Brvent/LSEI/README.md

# LSEI
Aquest projecte tracta de dissenyar i implementar un controlador de motor ESR
