Brvent/LSEI/Kicad/rcasado/ListaMaterial_CasadoRaul_VenturaBrandon.xlsx

Distribuidor | Dispositiu | Referència del fabricant | Referència del distribuïdor | Preu unitari | QUANTITAT Necessària | QUANTITAT Mínima | Preu Total | Link de compra | Comentaris
RS | Bloque de terminal PCB Macho RS PRO de 2 vías, paso 5.08mm, 10A, de color Verde, montaje Montaje en orificio pasante, | 146-8345 | 146-8345 | 0.584 € | 1 | 10 | 0.58 € | link (https://es.rs-online.com/web/p/bornes-para-pcb/1468345?gb=b) | Connector Alimentació (J6)
RS | Bloque de terminal PCB Hembra Ángulo recto RS PRO de 3 vías, paso 5.08mm, 25A, de color Verde, montaje Montaje en | 790-1155 | 790-1155 | 1.350 € | 1 | 5 | 1.35 € | link (https://es.rs-online.com/web/p/bornes-para-pcb/7901155?gb=b) | Connector Motor (J7)
RS | Regleta de pines Wurth Elektronik serie WR-PHD de 40 vías, 1 fila, paso 2.54mm, para soldar, Orificio Pasante | 61304011121 | 163-5305 | 0.72 € | 3 | 200 | 2.16 € | link (https://es.rs-online.com/web/p/conectores-macho-para-pcb/1635305?gb=s) | Tira mascle 2.54mm
RS | LED Lite-On, Rojo, 625 nm, Vf= 2,6 V, 60°, mont. pasante, encapsulado 3 mm (T-1) | LTL-4221N | 127-8400 | 0.07 € | 2 | 100 | 0.13 € | link (https://es.rs-online.com/web/p/leds/1278400?gb=s) | LED alimentació (D4, D5)
RS | MOSFET, IRFR1205TRPBF, N-Canal-Canal, 44 A, 55 V, 3-Pin, DPAK (TO-252) HEXFET Simple Si | IRFR1205TRPBF | 827-4026 | 1.31 € | 6 | 20 | 7.85 € | link (https://es.rs-online.com/web/p/mosfet/8303357/) | NMOS de potencia (Q1-Q7)
RS | Módulo controlador de puerta IR2301SPBF, CMOS, LSTTL 350 mA SOIC 8 pines | IR2301SPBF | 262-6704P | 1.32 € | 3 | 25 | 3.97 € | link (https://es.rs-online.com/web/p/drivers-de-potencia/2626704P) | Driver doble alt i baix per NMOS (IC2, IC3, IC4)
RS | Diodo, 1N4149, Pequeña señal, 500mA, 100V, 4ns, DO-35, 2-Pines | 1N4149 | 186-7651 | 0.04 € | 3 | 100 | 0.12 € | link (https://es.rs-online.com/web/p/diodos-schottky-y-rectificadores/1867651?gb=s) | Díode bootstrap (D1, D2, D3)
Farnell | Condensador Electrolítico Aluminio SMD, Radial - SMD, 470 µF, 35 V, 2000 horas a 105°C, Polar | MCVFZ035M471XB6L | 2627682 | 2.41 € | 1 | 1 | 2.41 € | link (https://es.farnell.com/multicomp/mcvfz035m471xb6l/conden-470-f-35v-smd/dp/2627682) | Condensador entrada alimentació radial SMT (C15)
RS | Potenciometro con película de carbono de 10kΩ, ±10%, 0.1W, serie RK163, 1 vuelta, eje de 6 mm de Ø, Montaje en Panel | RK1631110TWA | 172-6361 | 7.30 € | 1 | 1 | 7.30 € | link (https://es.rs-online.com/web/p/potenciometros/2499238?gb=s) | potenciometre de control duty ESC NO ES POT SOLDAR A LA PCB
RS | Regulador de tensión L7805CV, 1.5A, 3 pines | L7805CV | 918-1971 | 0.26 € | 1 | 50 | 0.26 € | link (https://es.rs-online.com/web/p/reguladores-de-tension/9181971?gb=s) | Regulador linial fix 5V, encapsulat TO-220 (U1)
RS | Regulador de tensión LMS8117AMP-3.3/NOPB, 1A SOT-223, 3+Tab pines | LMS8117AMP-3.3/NOPB | 536-0313P | 0.95 € | 1 | 15 | 0.95 € | link (https://es.rs-online.com/web/p/reguladores-de-tension/5360313P?cm_mmc=es-DS-APP-_-PCB-_-VIEW-_-5360313P) | Regulador 3.3V (IC5)
RS | Comparador LM339D Colector Abierto 1.3μs 4-Canales, 3 → 28 V 14-Pines SOIC | LM339D | 858-411 | 0.88 € | 1 | 1 | 0.88 € | link (https://es.rs-online.com/web/p/comparadores/0858411?gb=s) | Comparador BEMF (IC1)
Components SMD 1206
resistències | sèrie E6 des de 1Ohm fins a 1MEGOhm
condensadors (nF) | 0.1 - 1 - 2.2 - 3.3 - 4.7 - 6.8 - 10 - 22 -33 - 47 - 68 - 100 - 220 - 330 - 470 - 680 -1000 -2200 - 10000
