Brvent/LSEI/Kicad/rcasado/PCBLSE1_CasadoRaul_VenturaBrandon.kicad_pcb

## KiCad design Kicad/rcasado/PCBLSE1_CasadoRaul_VenturaBrandon.kicad_pcb (2026-10-15)

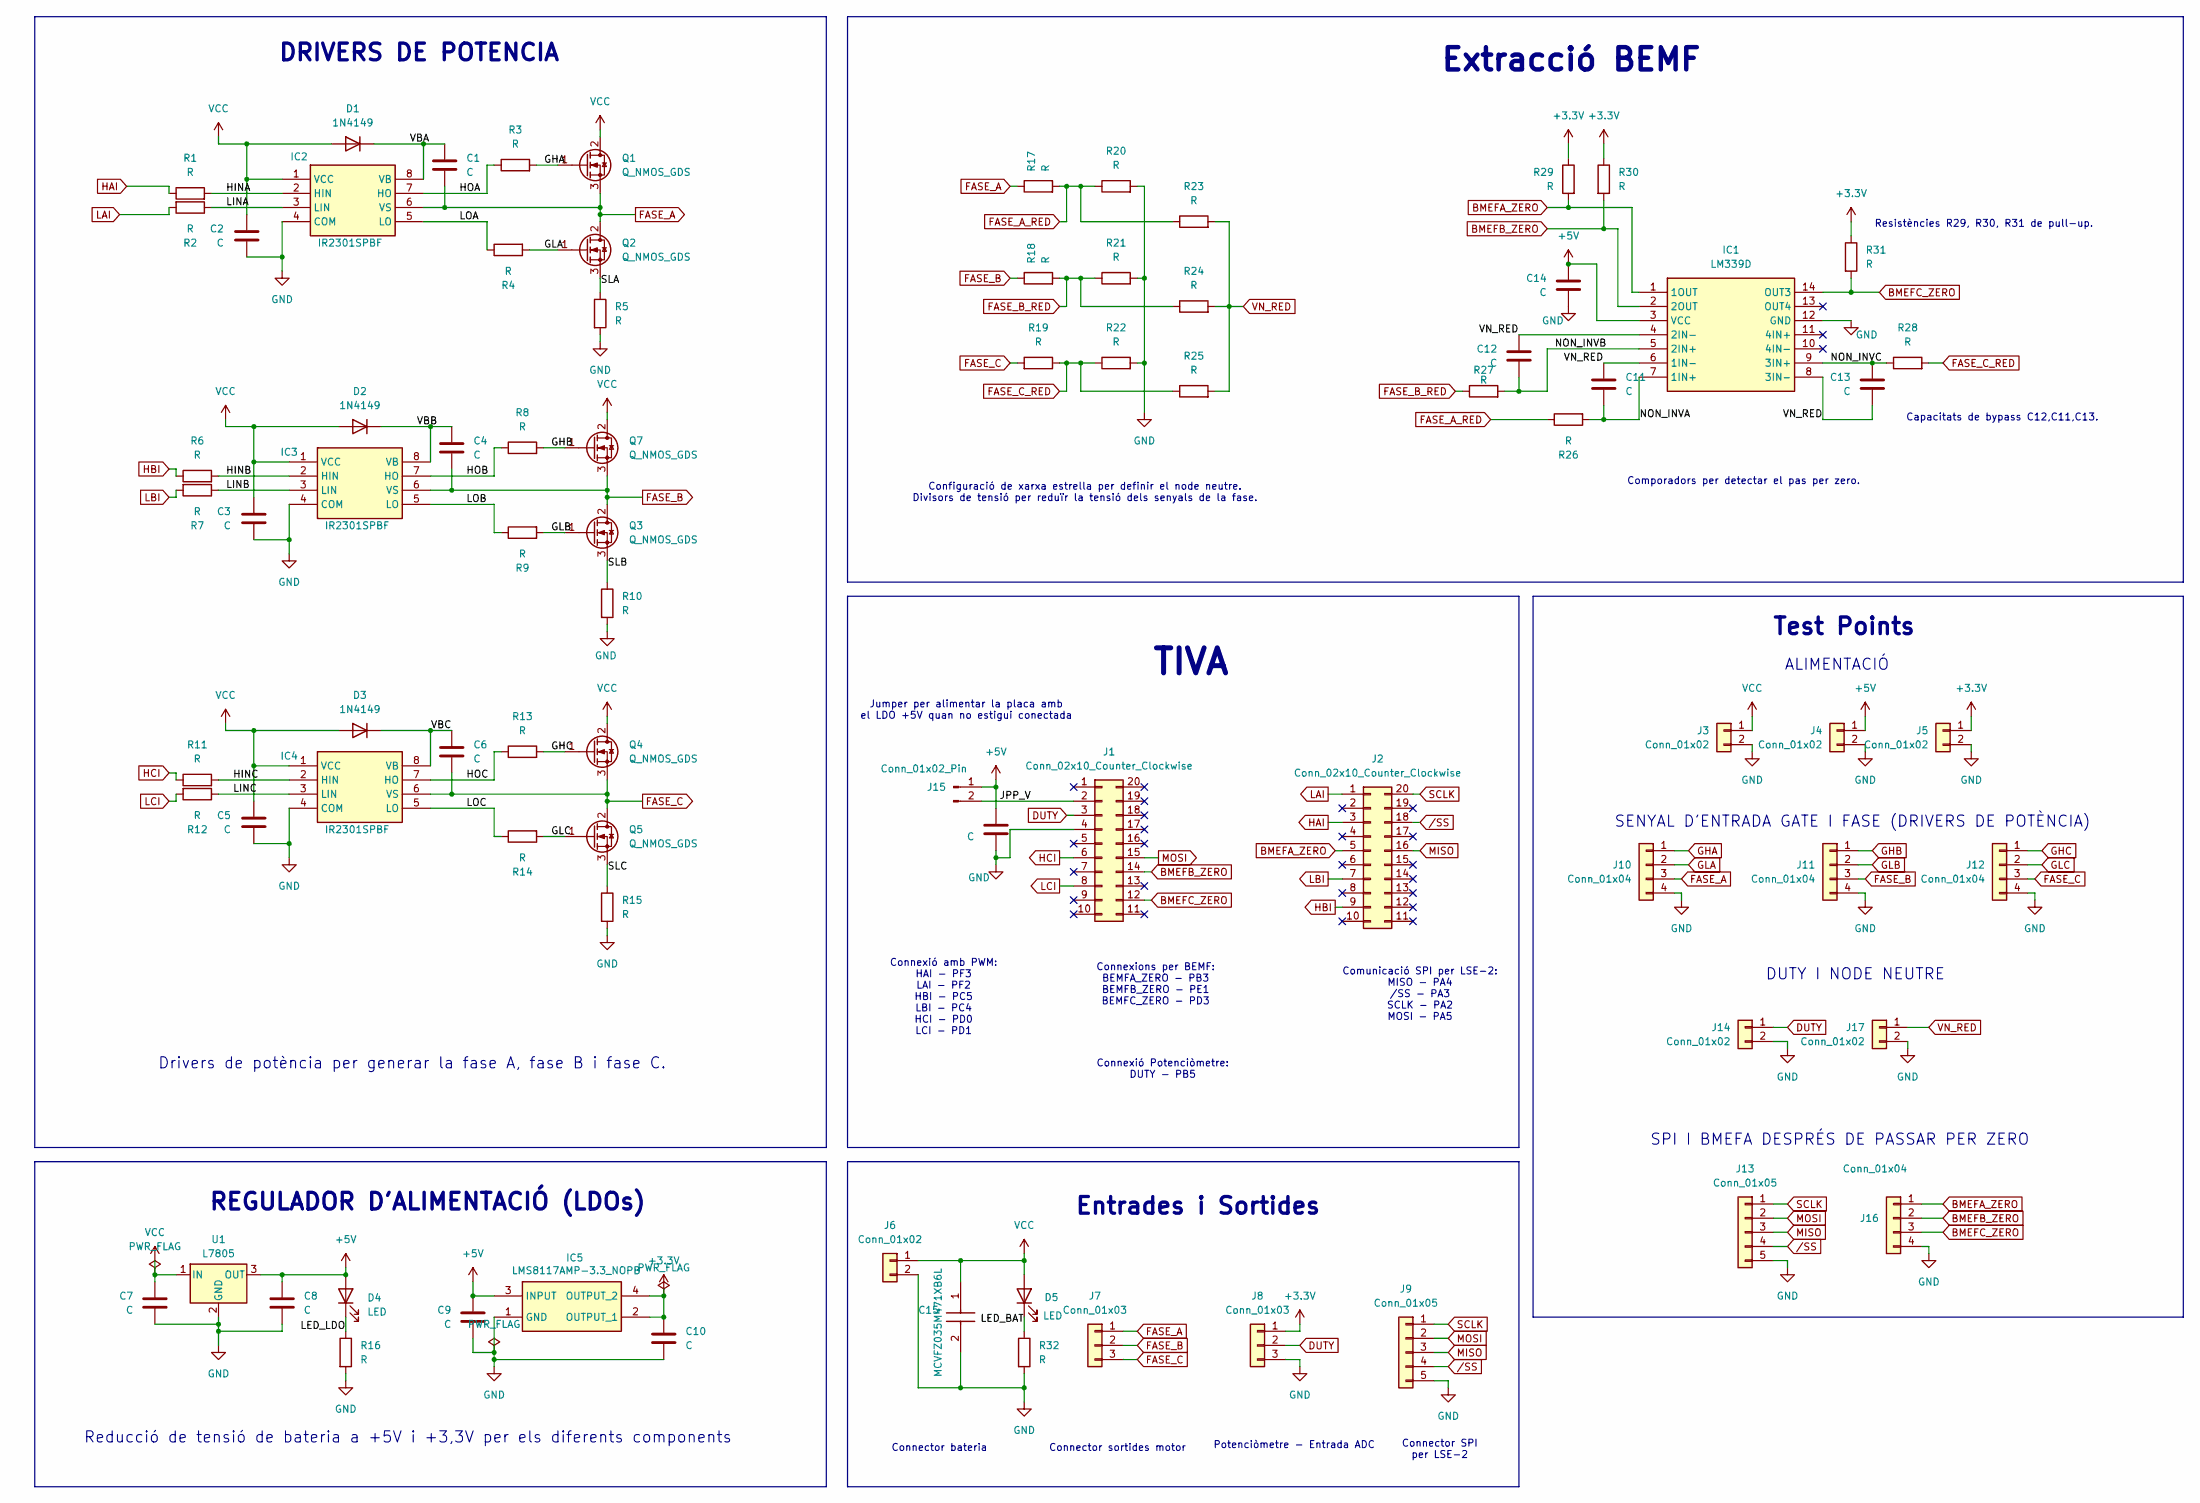
[picture p1: schematic PCBLSE1_CasadoRaul_VenturaBrandon.kicad_sch, PCB per control de velocitat de motor]

Parts:
C1, C2, C3, C4, C5, C6, C7, C8, C9, C10, C11, C12, C13, C14, C16: C; C_1206_3216Metric
C15: MCVFZ035M471XB6L; CAPAE1280X1300N; Manufacturer_Part_Number MCVFZ035M471XB6L
D1, D2, D3: 1N4149; D_DO-35_SOD27_P7.62mm_Horizontal
D4, D5: LED; LTL4221N
IC1: LM339D; SOIC127P600X175-14N; Mouser Part Number 595-LM339D
IC2, IC3, IC4: IR2301SPBF; SOIC127P600X175-8N; Mouser Part Number 942-IR2301SPBF
IC5: LMS8117AMP-3.3_NOPB; SOT230P700X180-4N; Mouser Part Number 926-LMS8117AMP33NOPB
J1, J2: Conn_02x10_Counter_Clockwise; PinHeader_2x10_P2.54mm_Vertical
J3, J4, J5, J14, J17: Conn_01x02; PinSocket_1x02_P2.54mm_Vertical
J6: Conn_01x02; TerminalBlock_Phoenix_MKDS-1,5-2-5.08_1x02_P5.08mm_Horizont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
J7: Conn_01x03; TerminalBlock_Phoenix_MKDS-1,5-3-5.08_1x03_P5.08mm_Horizont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
J8: Conn_01x03; PinSocket_1x03_P2.54mm_Vertical
J9, J13: Conn_01x05; PinSocket_1x05_P2.54mm_Vertical
J10, J11, J12, J16: Conn_01x04; PinSocket_1x04_P2.54mm_Vertical
J15: Conn_01x02_Pin; PinSocket_1x02_P2.54mm_Vertical
Q1, Q2, Q3, Q4, Q5, Q7: Q_NMOS_GDS; TO-252-2
R1, R2, R3, R4, R5, R6, R7, R8, R9, R10, R11, R12, R13, R14, R15, R16, R17, R18, R19, R20, R21, R22, R23, R24, R25, R26, R27, R28, R29, R30, R31, R32: R; R_1206_3216Metric
U1: L7805; TO255P460X1020X2008-3P

Connections:
+3.3V: C10.1, IC5.2 (OUTPUT_1), IC5.4 (OUTPUT_2), J5.1, J8.1, R29.1, R30.1, R31.1
+5V: C8.1, C9.1, C14.1, C16.1, D4.2 (A), IC1.3 (VCC), IC5.3 (INPUT), J4.1, J15.1, U1.3 (OUT)
/HINA: IC2.2 (HIN), R1.2
/HINB: IC3.2 (HIN), R6.2
/HINC: IC4.2 (HIN), R11.2
/HOA: IC2.7 (HO), R3.1
/HOB: IC3.7 (HO), R8.1
/HOC: IC4.7 (HO), R13.1
/JPP_V: J1.2, J15.2
/LED_BAT: D5.1 (K), R32.1
/LED_LDO: D4.1 (K), R16.1
/LINA: IC2.3 (LIN), R2.1
/LINB: IC3.3 (LIN), R7.1
/LINC: IC4.3 (LIN), R12.1
/LOA: IC2.5 (LO), R4.1
/LOB: IC3.5 (LO), R9.1
/LOC: IC4.5 (LO), R14.1
/NON_INVA: C11.2, IC1.7 (1IN+), R26.2
/NON_INVB: C12.2, IC1.5 (2IN+), R27.2
/NON_INVC: C13.1, IC1.9 (3IN+), R28.1
/SLA: Q2.3 (S), R5.1
/SLB: Q3.3 (S), R10.1
/SLC: Q5.3 (S), R15.1
/VBA: C1.1, D1.1 (K), IC2.8 (VB)
/VBB: C4.1, D2.1 (K), IC3.8 (VB)
/VBC: C6.1, D3.1 (K), IC4.8 (VB)
BMEFA_ZERO: IC1.1 (1OUT), J2.5, J16.1, R29.2
BMEFB_ZERO: IC1.2 (2OUT), J1.14, J16.2, R30.2
BMEFC_ZERO: IC1.14 (OUT3), J1.12, J16.3, R31.2
DUTY: J1.3, J8.2, J14.1
FASE_A: C1.2, IC2.6 (VS), J7.1, J10.3, Q1.3 (S), Q2.2 (D), R17.1
FASE_A_RED: R17.2, R20.1, R23.1, R26.1
FASE_B: C4.2, IC3.6 (VS), J7.2, J11.3, Q3.2 (D), Q7.3 (S), R18.1
FASE_B_RED: R18.2, R21.1, R24.1, R27.1
FASE_C: C6.2, IC4.6 (VS), J7.3, J12.3, Q4.3 (S), Q5.2 (D), R19.2
FASE_C_RED: R19.1, R22.1, R25.1, R28.2
GHA: J10.1, Q1.1 (G), R3.2
GHB: J11.1, Q7.1 (G), R8.2
GHC: J12.1, Q4.1 (G), R13.2
GLA: J10.2, Q2.1 (G), R4.2
GLB: J11.2, Q3.1 (G), R9.2
GLC: J12.2, Q5.1 (G), R14.2
GND: C2.2, C3.2, C5.2, C7.2, C8.2, C9.2, C10.2, C14.2, C15.2 (-), C16.2, IC1.12 (GND), IC2.4 (COM), IC3.4 (COM), IC4.4 (COM), IC5.1 (GND), J1.4, J3.2, J4.2, J5.2, J6.2, J8.3, J9.5, J10.4, J11.4, J12.4, J13.5, J14.2, J16.4, J17.2, R5.2, R10.2, R15.2, R16.2, R20.2, R21.2, R22.2, R32.2, U1.2 (GND)
HAI: J2.3, R1.1
HBI: J2.9, R6.1
HCI: J1.6, R11.1
LAI: J2.1, R2.2
LBI: J2.7, R7.2
LCI: J1.8, R12.2
MISO: J2.16, J9.3, J13.3
MOSI: J1.15, J9.2, J13.2
SCLK: J2.20, J9.1, J13.1
VCC: C2.1, C3.1, C5.1, C7.1, C15.1 (+), D1.2 (A), D2.2 (A), D3.2 (A), D5.2 (A), IC2.1 (VCC), IC3.1 (VCC), IC4.1 (VCC), J3.1, J6.1, Q1.2 (D), Q4.2 (D), Q7.2 (D), U1.1 (IN)
VN_RED: C11.1, C12.1, C13.2, IC1.4 (2IN-), IC1.6 (1IN-), IC1.8 (3IN-), J17.1, R23.2, R24.2, R25.2
/SS: J2.18, J9.4, J13.4

Notes on the sheet:
Capacitats de bypass C12,C11,C13.
DRIVERS DE POTENCIA
Extracció BEMF
REGULADOR D'ALIMENTACIÓ (LDOs)
Drivers de potència per generar la fase A, fase B i fase C.
Potenciòmetre - Entrada ADC
Connector SPI per LSE-2
Jumper per alimentar la placa amb el LDO +5V quan no estigui conectada
Connexió Potenciòmetre: DUTY - PB5
Configuració de xarxa estrella per definir el node neutre. Divisors de tensió per reduïr la tensió dels senyals de la fase.
DUTY I NODE NEUTRE
SENYAL D'ENTRADA GATE I FASE (DRIVERS DE POTÈNCIA)
Comporadors per detectar el pas per zero.
SPI I BMEFA DESPRÉS DE PASSAR PER ZERO
Resistències R29, R30, R31 de pull-up.
Entrades i Sortides
Connexió amb PWM: HAI - PF3 LAI - PF2 HBI - PC5 LBI - PC4 HCI - PD0 LCI - PD1
Reducció de tensió de bateria a +5V i +3,3V per els diferents components
Connector bateria
ALIMENTACIÓ
Connexions per BEMF: BEMFA_ZERO - PB3 BEMFB_ZERO - PE1 BEMFC_ZERO - PD3
Test Points
TIVA
Comunicació SPI per LSE-2: MISO - PA4 /SS - PA3 SCLK - PA2 MOSI - PA5
Connector sortides motor

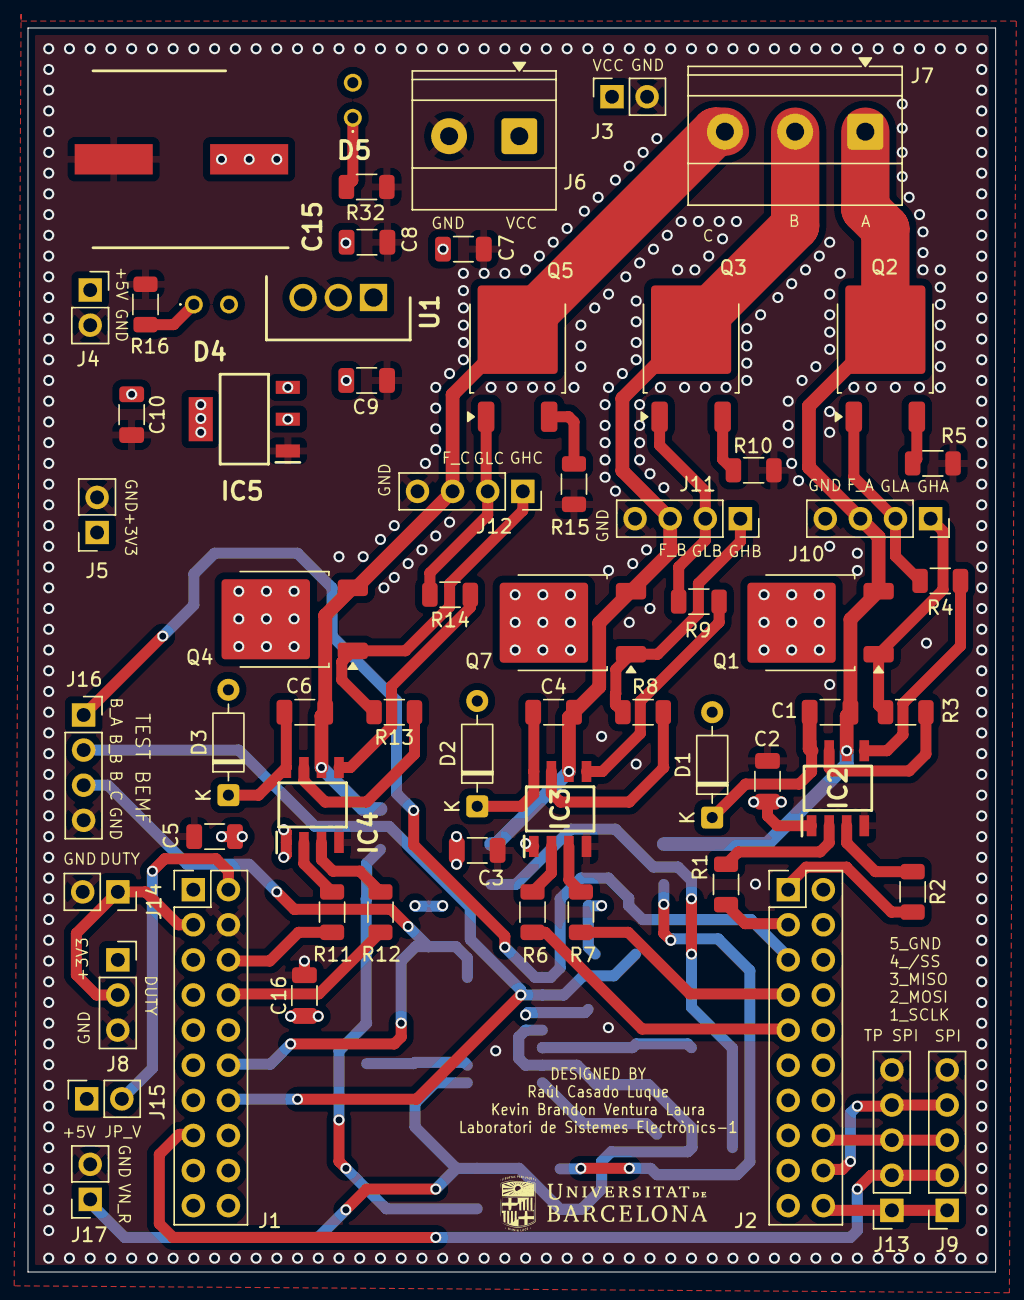
[picture p2: board PCBLSE1_CasadoRaul_VenturaBrandon.kicad_pcb from above]

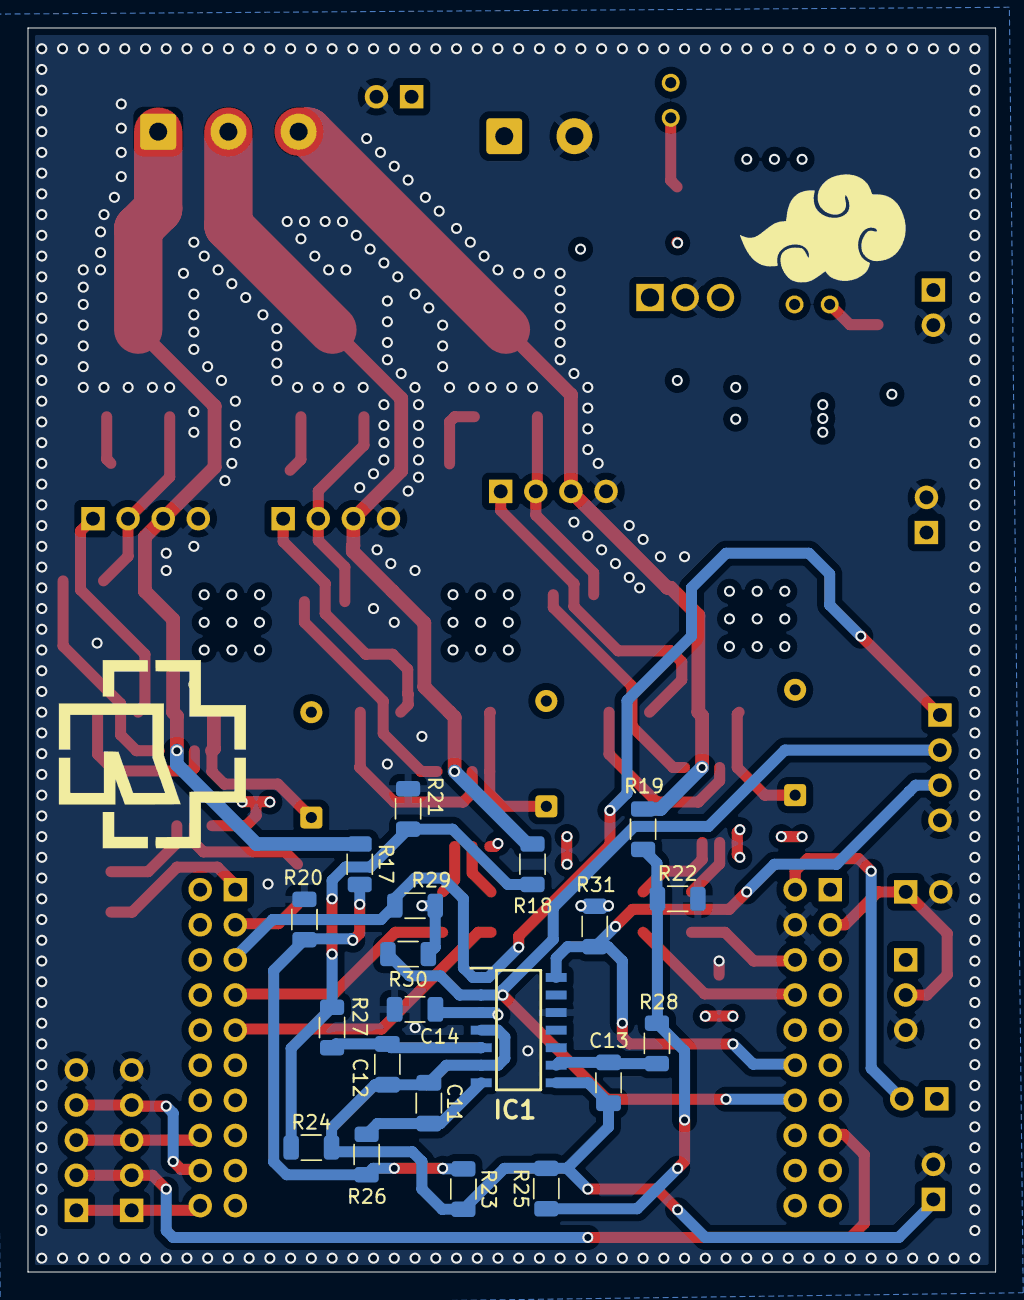
[picture p3: board PCBLSE1_CasadoRaul_VenturaBrandon.kicad_pcb from below]

Board: 4 copper layers, 70.0 x 90.0 mm, 82 parts (20 on the bottom side), 55 nets.
