Brvent/LSEI/Kicad/rcasado/ESC_BLDC_LSE1.kicad_pcb

## KiCad design Kicad/rcasado/ESC_BLDC_LSE1.kicad_pcb (2026-10-07)

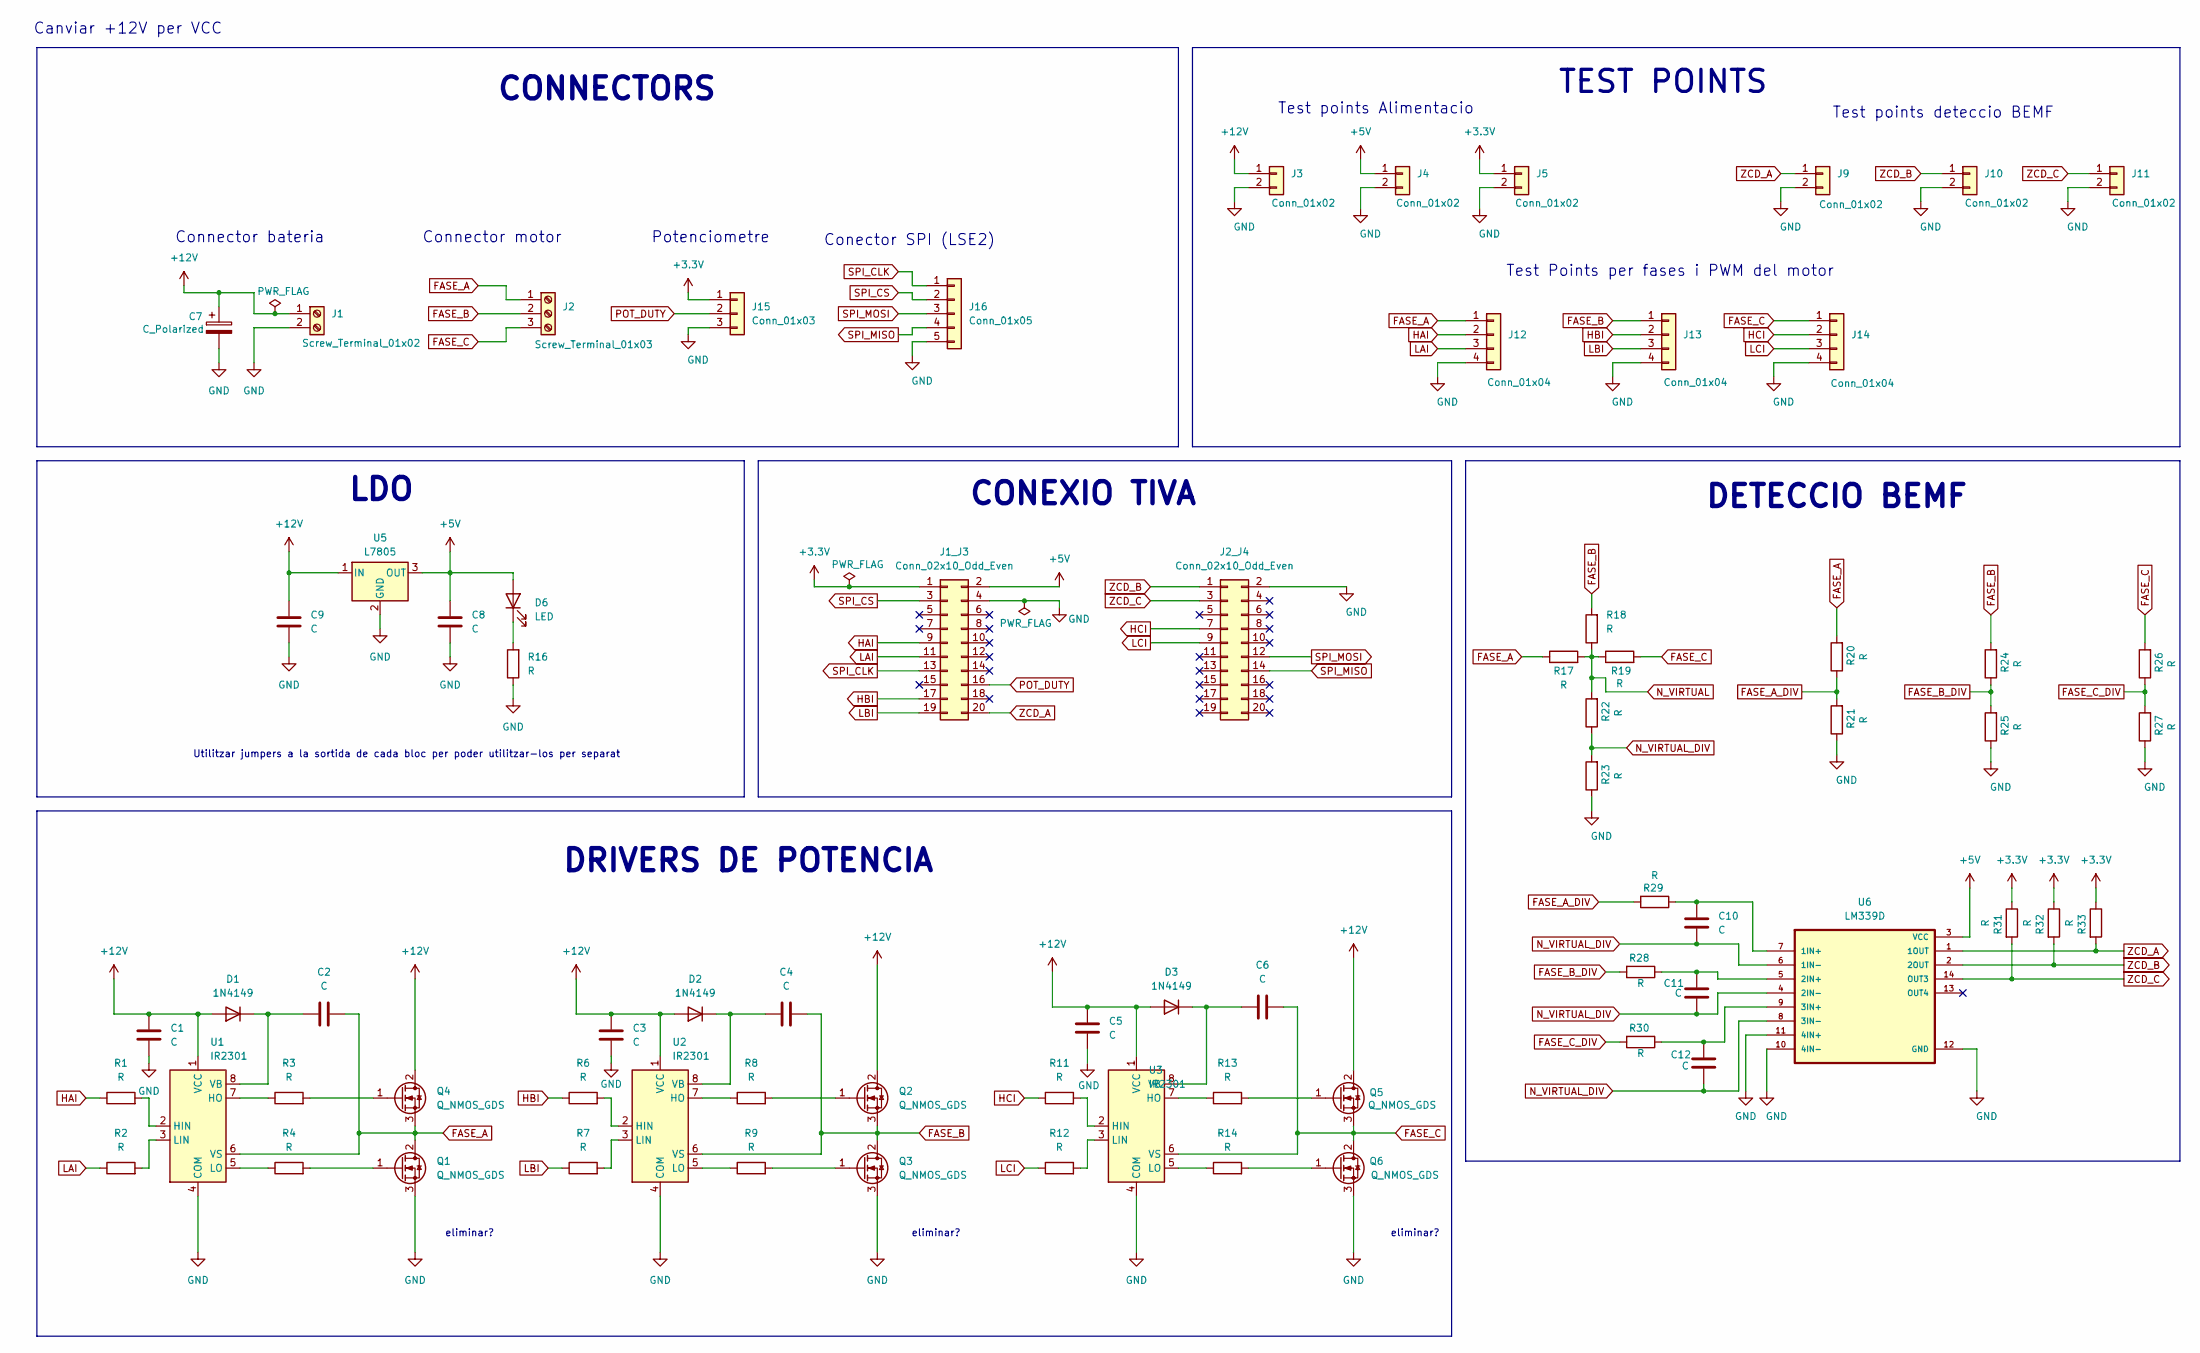
[picture p4: schematic ESC_BLDC_LSE1.kicad_sch]

Parts:
C1, C2, C3, C4, C5, C6, C8, C9, C10, C11, C12: C; C_1206_3216Metric_Pad1.33x1.80mm_HandSolder
C7: C_Polarized; CP_Radial_D10.0mm_P5.00mm
D1, D2, D3: 1N4149; D_DO-35_SOD27_P7.62mm_Horizontal
D6: LED; LED_D3.0mm
J1: Screw_Terminal_01x02; TerminalBlock_Phoenix_MKDS-1,5-2-5.08_1x02_P5.08mm_Horizont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
J1_J3, J2_J4: Conn_02x10_Odd_Even; PinSocket_2x10_P2.54mm_Vertical
J2: Screw_Terminal_01x03; TerminalBlock_Phoenix_MKDS-1,5-3-5.08_1x03_P5.08mm_Horizont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
J3, J4, J5, J9, J10, J11: Conn_01x02; PinHeader_1x02_P2.54mm_Vertical
J12, J13, J14: Conn_01x04; PinHeader_1x04_P2.54mm_Vertical
J15: Conn_01x03; PinHeader_1x03_P2.54mm_Vertical
J16: Conn_01x05; PinHeader_1x05_P2.54mm_Vertical
Q1, Q2, Q3, Q4, Q5, Q6: Q_NMOS_GDS; TO-252-2
R1, R2, R3, R4, R6, R7, R8, R9, R11, R12, R13, R14, R16, R17, R18, R19, R20, R21, R22, R23, R24, R25, R26, R27, R28, R29, R30, R31, R32, R33: R; R_1206_3216Metric_Pad1.30x1.75mm_HandSolder
U1, U2, U3: IR2301; SOIC-8_3.9x4.9mm_P1.27mm
U5: L7805; TO-252-3_TabPin2
U6: LM339D; SOIC127P600X175-14N

Connections:
+3.3V: J1_J3.1, J5.1, J15.1, R31.1, R32.1, R33.1
+5V: C8.2, D6.2 (A), J1_J3.2, J4.1, U5.3 (OUT), U6.3 (VCC)
+12V: C1.1, C3.1, C5.1, C7.1, C9.2, D1.2 (A), D2.2 (A), D3.2 (A), J1.1, J3.1, Q2.2 (D), Q4.2 (D), Q5.2 (D), U1.1 (VCC), U2.1 (VCC), U3.1 (VCC), U5.1 (IN)
FASE_A: C2.2, J2.1, J12.1, Q1.2 (D), Q4.3 (S), R17.1, R20.2, U1.6 (VS)
FASE_A_DIV: R20.1, R21.2, R29.2
FASE_B: C4.2, J2.2, J13.1, Q2.3 (S), Q3.2 (D), R18.2, R24.2, U2.6 (VS)
FASE_B_DIV: R24.1, R25.2, R28.2
FASE_C: C6.2, J2.3, J14.1, Q5.3 (S), Q6.2 (D), R19.2, R26.2, U3.6 (VS)
FASE_C_DIV: R26.1, R27.2, R30.2
GND: C1.2, C3.2, C5.2, C7.2, C8.1, C9.1, J1.2, J1_J3.4, J2_J4.2, J3.2, J4.2, J5.2, J9.2, J10.2, J11.2, J12.4, J13.4, J14.4, J15.3, J16.5, Q1.3 (S), Q3.3 (S), Q6.3 (S), R16.1, R21.1, R23.1, R25.1, R27.1, U1.4 (COM), U2.4 (COM), U3.4 (COM), U5.2 (GND), U6.10 (4IN-), U6.11 (4IN+), U6.12 (GND)
HAI: J1_J3.9, J12.2, R1.1
HBI: J1_J3.17, J13.2, R6.1
HCI: J2_J4.7, J14.2, R11.1
LAI: J1_J3.11, J12.3, R2.1
LBI: J1_J3.19, J13.3, R7.1
LCI: J2_J4.9, J14.3, R12.1
N_VIRTUAL: R17.2, R18.1, R19.1, R22.2
N_VIRTUAL_DIV: C10.1, C11.1, C12.1, R22.1, R23.2, U6.4 (2IN-), U6.6 (1IN-), U6.8 (3IN-)
unnamed: C2.1, D1.1 (K), U1.8 (VB)
unnamed: C4.1, D2.1 (K), U2.8 (VB)
unnamed: C6.1, D3.1 (K), U3.8 (VB)
unnamed: D6.1 (K), R16.2
unnamed: Q1.1 (G), R4.2
unnamed: Q2.1 (G), R8.2
unnamed: Q3.1 (G), R9.2
unnamed: Q4.1 (G), R3.2
unnamed: Q5.1 (G), R13.2
unnamed: Q6.1 (G), R14.2
unnamed: R1.2, U1.2 (HIN)
unnamed: R3.1, U1.7 (HO)
unnamed: R2.2, U1.3 (LIN)
unnamed: R4.1, U1.5 (LO)
unnamed: R6.2, U2.2 (HIN)
unnamed: R8.1, U2.7 (HO)
unnamed: R7.2, U2.3 (LIN)
unnamed: R9.1, U2.5 (LO)
unnamed: R11.2, U3.2 (HIN)
unnamed: R13.1, U3.7 (HO)
unnamed: R12.2, U3.3 (LIN)
unnamed: R14.1, U3.5 (LO)
unnamed: C10.2, R29.1, U6.7 (1IN+)
unnamed: C11.2, R28.1, U6.5 (2IN+)
unnamed: C12.2, R30.1, U6.9 (3IN+)
POT_DUTY: J1_J3.16, J15.2
SPI_CLK: J1_J3.13, J16.1
SPI_CS: J1_J3.3, J16.2
SPI_MISO: J2_J4.14, J16.4
SPI_MOSI: J2_J4.12, J16.3
ZCD_A: J1_J3.20, J9.1, R33.2, U6.1 (1OUT)
ZCD_B: J2_J4.1, J10.1, R32.2, U6.2 (2OUT)
ZCD_C: J2_J4.3, J11.1, R31.2, U6.14 (OUT3)

Notes on the sheet:
Connector bateria
DETECCIO BEMF
Utilitzar jumpers a la sortida de cada bloc per poder utilitzar-los per separat
LDO
CONEXIO TIVA
TEST POINTS
Potenciometre
Conector SPI (LSE2)
eliminar?
CONNECTORS
Test points Alimentacio
Connector motor
Canviar +12V per VCC
DRIVERS DE POTENCIA
Test points deteccio BEMF
Test Points per fases i PWM del motor

Board: 4 copper layers, 72 parts (23 on the bottom side), 51 nets, no tracks yet.
