Brvent/LSEI/(commit log)

2026-10-07 Add files via upload
    projecte LSE1 kicad ventura
    [PCBLSE1.kicad_pcb, PCBLSE1.kicad_sch]
2026-10-07 Add files via upload
    Projecte LSE1 KICad Raul
    [ESC_BLDC_LSE1.kicad_pcb, ESC_BLDC_LSE1.kicad_sch]
2026-10-13 Errors corregits
    Errors corregits de l'esquema i nou placement dels drivers de potència. DRC esquema 3 errors, relacionats amb el power flag.
2026-10-14 Add files via upload
    3 errors DRC solucionats (Referencia R6 i us de vies GND per conectar illes desconectades del pla de massa de Bottom)
2026-10-14 versió final kicad
